manushri-d/ece445/chinmayee/LED_strip_research.png

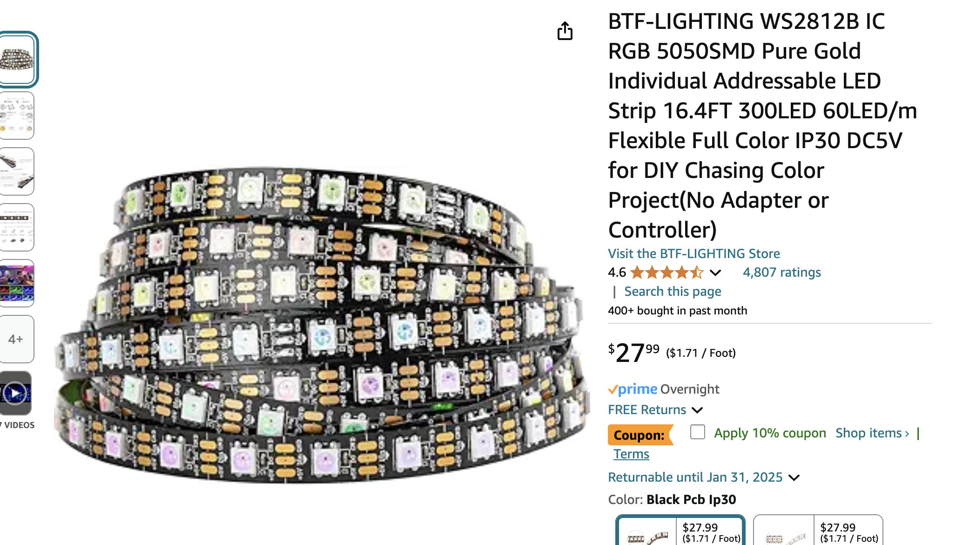
chinmayee/LED_strip_research.png
