manushri-d/ece445/README.md

# Team 41 FA 2024 ECE 445 Digital Lab Notebook

This repo is used for our Senior Design class where we put all of our updates for the semester!

Check [this link](https://courses.grainger.illinois.edu/ece445/projects.asp) for more information on our project (as well as some other projects!)
