manushri-d/ece445/(list of files, cad)

Other CAD files:
platev3.gcode.3mf
boxv3.gcode.3mf
