manushri-d/ece445/mounted_system/PrintedSchematic.pdf

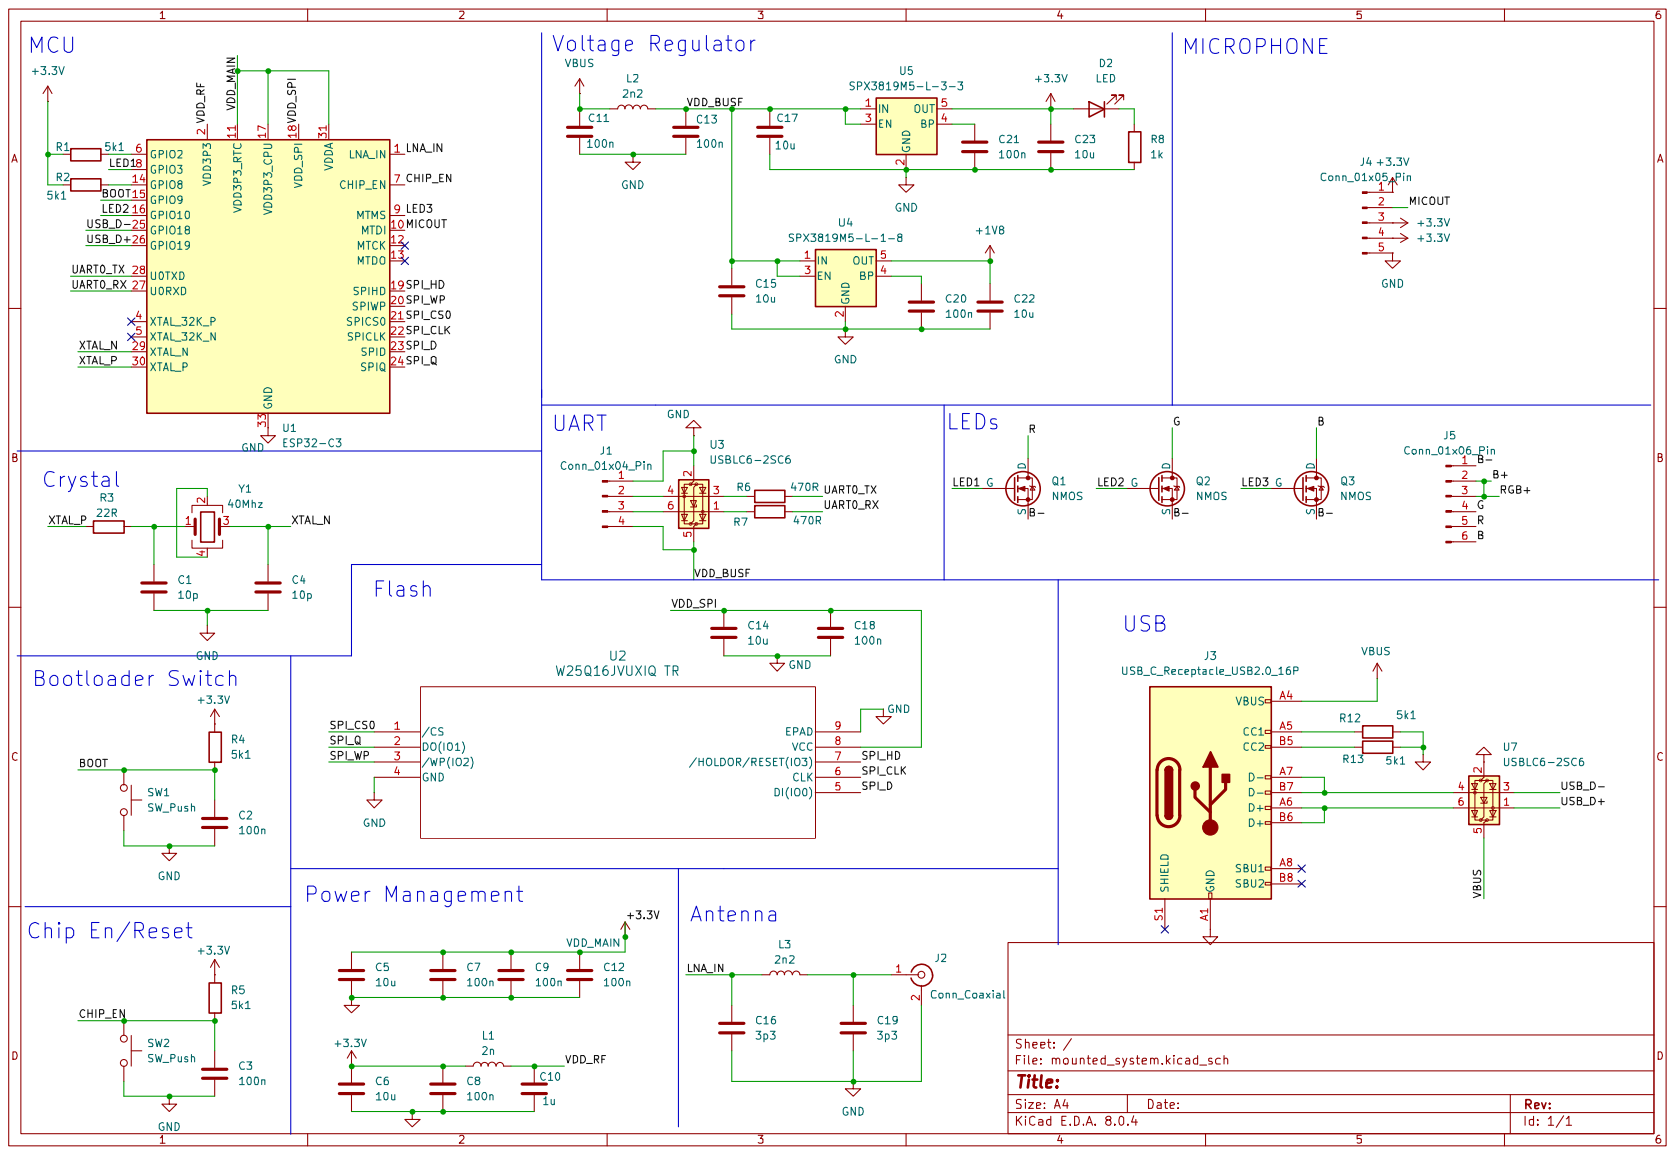
[picture p19: page 1]
