manushri-d/ece445/mounted_system/mounted_system.kicad_pcb

## KiCad design mounted_system/mounted_system.kicad_pcb (2024-11-15)

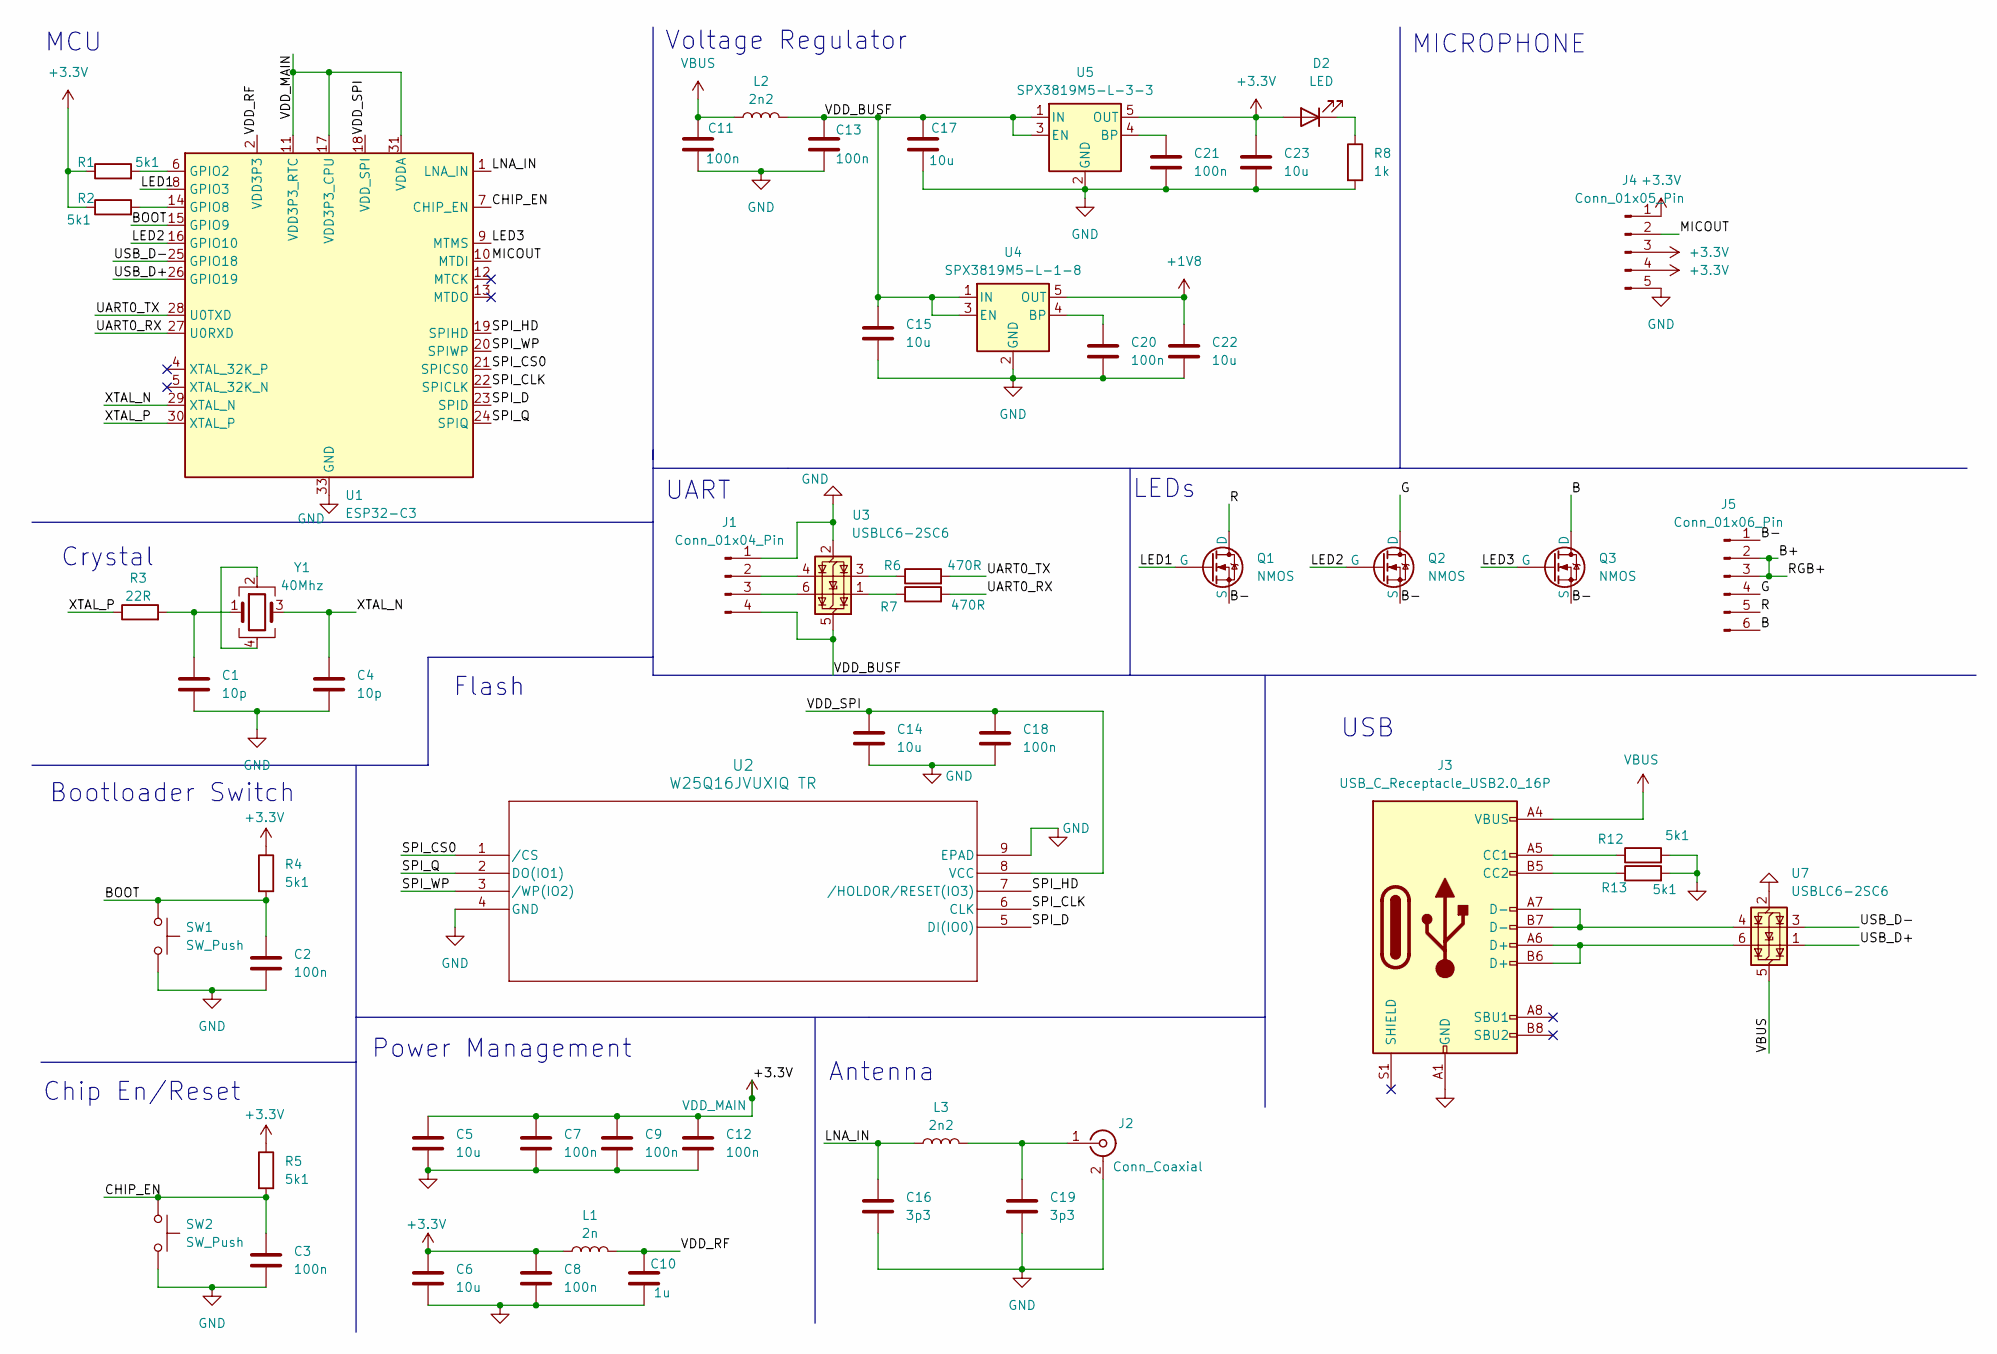
[picture p20: schematic mounted_system.kicad_sch]

Parts:
C1, C4: 10p; C_0805_2012Metric_Pad1.18x1.45mm_HandSolder
C2, C3, C7, C8, C9, C11, C12, C13, C18, C20, C21: 100n; C_0805_2012Metric_Pad1.18x1.45mm_HandSolder
C5, C6, C14, C15, C17, C22, C23: 10u; C_0805_2012Metric_Pad1.18x1.45mm_HandSolder
C10: 1u; C_0805_2012Metric_Pad1.18x1.45mm_HandSolder
C16, C19: 3p3; C_0805_2012Metric_Pad1.18x1.45mm_HandSolder
D2: LED; LED_0805_2012Metric_Pad1.15x1.40mm_HandSolder
J1: Conn_01x04_Pin; PinSocket_1x04_P2.00mm_Vertical
J2: Conn_Coaxial; MMCX_Molex_73415-1471_Vertical
J3: USB_C_Receptacle_USB2.0_16P; USB_C_Receptacle_XKB_U262-16XN-4BVC11
J4: Conn_01x05_Pin; PinSocket_1x05_P2.00mm_Vertical_SMD_Pin1Right
J5: Conn_01x06_Pin; PinSocket_1x06_P2.00mm_Vertical_SMD_Pin1Right
L1: 2n; L_0805_2012Metric_Pad1.15x1.40mm_HandSolder
L2, L3: 2n2; L_0805_2012Metric_Pad1.15x1.40mm_HandSolder
Q1, Q2, Q3: NMOS; TO-247-3_Vertical
R1, R2, R4, R5, R12, R13: 5k1; R_0805_2012Metric_Pad1.20x1.40mm_HandSolder
R3: 22R; R_0805_2012Metric_Pad1.20x1.40mm_HandSolder
R6, R7: 470R; R_0805_2012Metric_Pad1.20x1.40mm_HandSolder
R8: 1k; R_0805_2012Metric_Pad1.20x1.40mm_HandSolder
SW1, SW2: SW_Push; SW_SPST_PTS645
U1: ESP32-C3; QFN-32-1EP_5x5mm_P0.5mm_EP3.7x3.7mm
U2: W25Q16JVUXIQ TR; USON-8_UX_2x3x0p6_WIN
U3, U7: USBLC6-2SC6; SOT-23-6
U4: SPX3819M5-L-1-8; SOT-23-5
U5: SPX3819M5-L-3-3; SOT-23-5
Y1: 40Mhz; Crystal_SMD_EuroQuartz_MQ-4Pin_7.0x5.0mm_HandSoldering

Connections:
+1V8: C22.1, U4.5 (OUT)
+3.3V: C5.1, C6.1, C7.1, C8.1, C9.1, C12.1, C23.1, D2.2 (A), J4.1, J4.3, J4.4, L1.1, R1.1, R2.1, R4.1, R5.1, U1.11 (VDD3P3_RTC), U1.17 (VDD3P3_CPU), U1.31 (VDDA), U1.32 (VDDA), U5.5 (OUT)
/B: J5.6, Q3.1 (D)
/B+: J5.2, J5.3
/B-: J5.1, Q1.3 (S), Q2.3 (S), Q3.3 (S)
/BOOT: C2.1, R4.2, SW1.1, U1.15 (GPIO9)
/CHIP_EN: C3.1, R5.2, SW2.1, U1.7 (CHIP_EN)
/G: J5.4, Q2.1 (D)
/LED1: Q1.2 (G), U1.8 (GPIO3)
/LED2: Q2.2 (G), U1.16 (GPIO10)
/LED3: Q3.2 (G), U1.9 (MTMS)
/LNA_IN: C16.1, L3.1, U1.1 (LNA_IN)
/MICOUT: J4.2, U1.10 (MTDI)
/R: J5.5, Q1.1 (D)
/SPI_CLK: U1.22 (SPICLK), U2.6 (CLK)
/SPI_CS0: U1.21 (SPICS0), U2.1 (/CS)
/SPI_D: U1.23 (SPID), U2.5 (DI(IO0))
/SPI_HD: U1.19 (SPIHD), U2.7 (/HOLDOR/RESET(IO3))
/SPI_Q: U1.24 (SPIQ), U2.2 (DO(IO1))
/SPI_WP: U1.20 (SPIWP), U2.3 (/WP(IO2))
/UART0_RX: R7.2, U1.27 (U0RXD)
/UART0_TX: R6.2, U1.28 (U0TXD)
/USB_D+: U1.26 (GPIO19), U7.1 (I/O1)
/USB_D-: U1.25 (GPIO18), U7.3 (I/O2)
/VDD_BUSF: C13.1, C15.1, C17.1, J1.4, L2.2, U3.5 (VBUS), U4.1 (IN), U4.3 (EN), U5.1 (IN), U5.3 (EN)
/VDD_RF: C10.1, L1.2, U1.2 (VDD3P3), U1.3 (VDD3P3)
/VDD_SPI: C14.1, C18.1, U1.18 (VDD_SPI), U2.8 (VCC)
/XTAL_N: C4.1, U1.29 (XTAL_N), Y1.3
/XTAL_P: R3.1, U1.30 (XTAL_P)
GND: C1.2, C2.2, C3.2, C4.2, C5.2, C6.2, C7.2, C8.2, C9.2, C10.2, C11.2, C12.2, C13.2, C14.2, C15.2, C16.2, C17.2, C18.2, C19.2, C20.2, C21.2, C22.2, C23.2, J1.1, J2.2 (Ext), J3.A1 (GND), J3.A12 (GND), J3.B1 (GND), J3.B12 (GND), J4.5, R8.2, R12.2, R13.2, SW1.2, SW2.2, U1.33 (GND), U2.4 (GND), U2.9 (EPAD), U3.2 (GND), U4.2 (GND), U5.2 (GND), U7.2 (GND)
unnamed: C1.1, R3.2, Y1.1
unnamed: D2.1 (K), R8.1
unnamed: J1.2, U3.4 (I/O2)
unnamed: J1.3, U3.6 (I/O1)
unnamed: C19.1, J2.1 (In), L3.2
unnamed: J3.A5 (CC1), R12.1
unnamed: J3.B5 (CC2), R13.1
unnamed: J3.A6 (D+), J3.B6 (D+), U7.6 (I/O1)
unnamed: J3.A7 (D-), J3.B7 (D-), U7.4 (I/O2)
unnamed: R6.1, U3.3 (I/O2)
unnamed: R7.1, U3.1 (I/O1)
unnamed: R1.2, U1.6 (GPIO2)
unnamed: R2.2, U1.14 (GPIO8)
unnamed: C20.1, U4.4 (BP)
unnamed: C21.1, U5.4 (BP)
unnamed: Y1.2, Y1.4
VBUS: C11.1, J3.A4 (VBUS), J3.A9 (VBUS), J3.B4 (VBUS), J3.B9 (VBUS), L2.1, U7.5 (VBUS)

Notes on the sheet:
USB
UART
MCU
Chip En/Reset
Voltage Regulator
Bootloader Switch
MICROPHONE
Crystal
Antenna
Power Management
LEDs
Flash

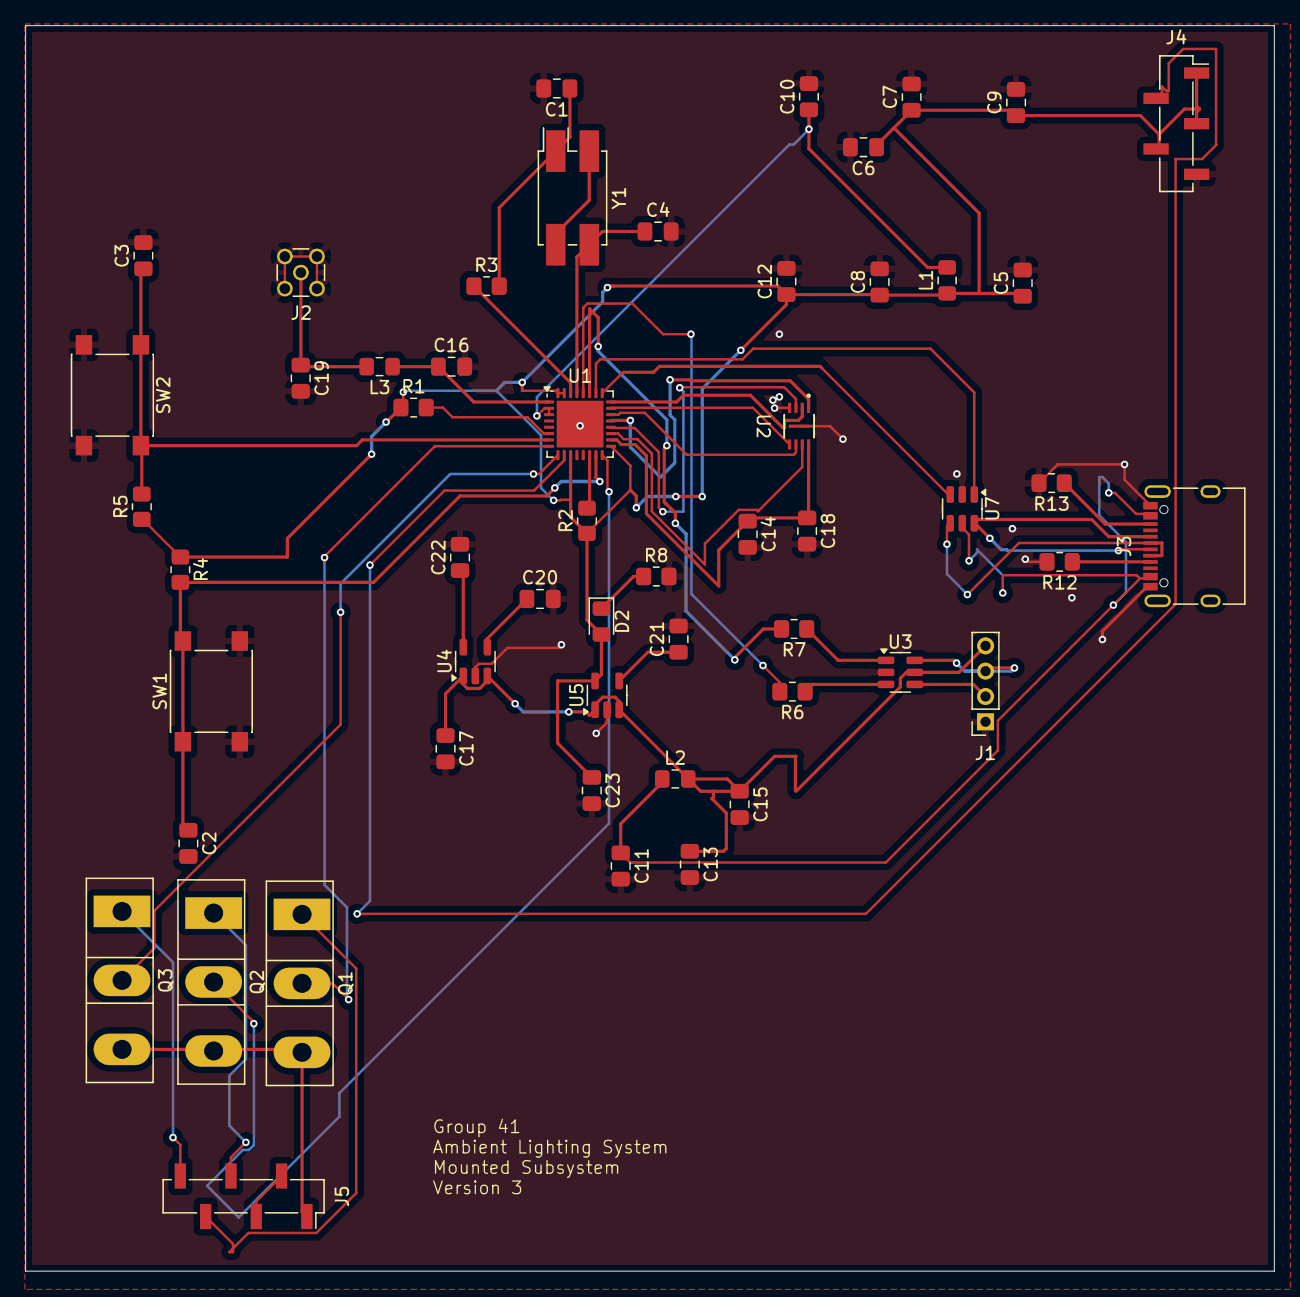
[picture p21: board mounted_system.kicad_pcb from above]

Board: 2 copper layers, 98.7 x 98.4 mm, 54 parts (0 on the bottom side), 47 nets.
