manushri-d/ece445/wearablesystem/wearablesystem.kicad_pcb

## KiCad design wearablesystem/wearablesystem.kicad_pcb (2024-11-14)

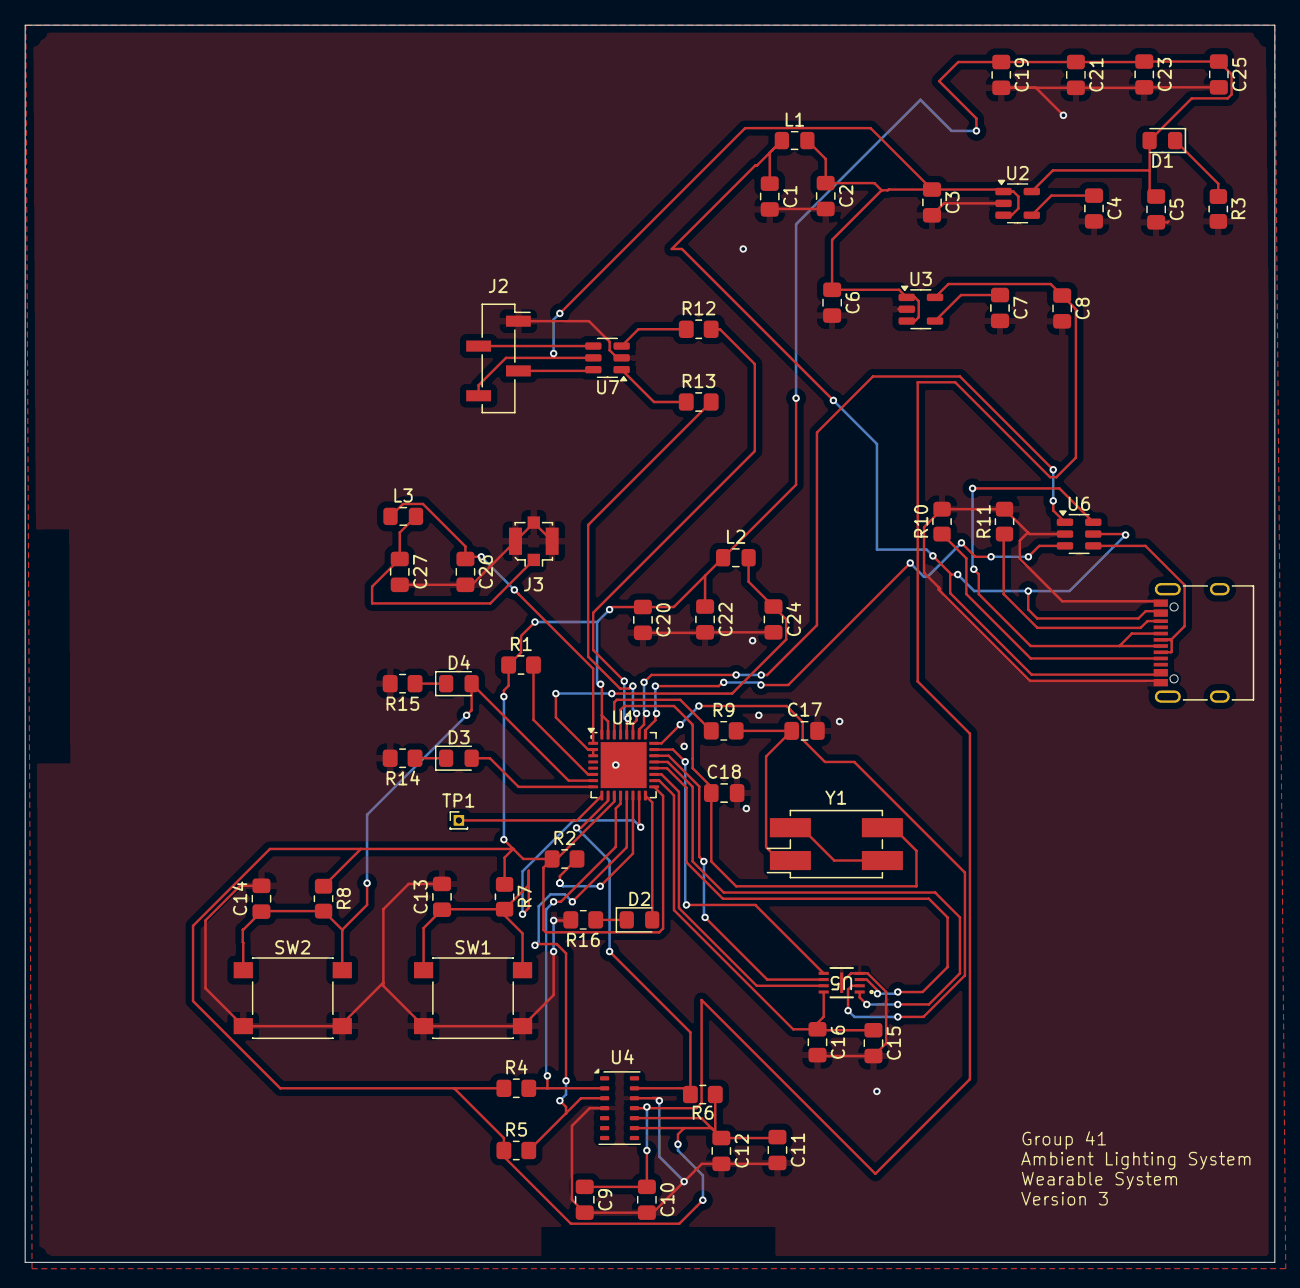
[picture p22: board wearablesystem.kicad_pcb from above]

Board: 2 copper layers, 100.5 x 99.5 mm, 64 parts (0 on the bottom side), 47 nets.

Parts:
C1, C2, C4, C7, C9, C12, C13, C14, C16, C21, C22, C23, C25: 100n; C_0805_2012Metric_Pad1.18x1.45mm_HandSolder
C3, C5, C6, C8, C10, C15, C19, C20: 10u; C_0805_2012Metric_Pad1.18x1.45mm_HandSolder
C11, C24: 1u; C_0805_2012Metric_Pad1.18x1.45mm_HandSolder
C17, C18: 10p; C_0805_2012Metric_Pad1.18x1.45mm_HandSolder
C26, C27: 3p3; C_0805_2012Metric_Pad1.18x1.45mm_HandSolder
D1, D2, D3, D4: LED; LED_0805_2012Metric_Pad1.15x1.40mm_HandSolder
J1: USB_C_Receptacle_USB2.0_16P; USB_C_Receptacle_XKB_U262-16XN-4BVC11
J2: Conn_01x04_Pin; PinSocket_1x04_P2.00mm_Vertical_SMD_Pin1Right
J3: Conn_Coaxial; U.FL_Molex_MCRF_73412-0110_Vertical
L1, L3: 2n2; L_0805_2012Metric_Pad1.15x1.40mm_HandSolder
L2: 2n; L_0805_2012Metric_Pad1.15x1.40mm_HandSolder
R1, R2, R7, R8, R10, R11: 5k1; R_0805_2012Metric_Pad1.20x1.40mm_HandSolder
R3, R14, R15, R16: 1k; R_0805_2012Metric_Pad1.20x1.40mm_HandSolder
R4, R5, R6: 1k5; R_0805_2012Metric_Pad1.20x1.40mm_HandSolder
R9: 22R; R_0805_2012Metric_Pad1.20x1.40mm_HandSolder
R12, R13: 470R; R_0805_2012Metric_Pad1.20x1.40mm_HandSolder
SW1, SW2: SW_Push; SW_SPST_PTS645
TP1: TestPoint; PinHeader_1x01_P1.00mm_Vertical
U1: ESP32-C3; QFN-32-1EP_5x5mm_P0.5mm_EP3.7x3.7mm
U2: SPX3819M5-L-3-3; SOT-23-5
U3: SPX3819M5-L-1-8; SOT-23-5
U4: MAX30102; Maxim_OLGA-14_3.3x5.6mm_P0.8mm
U5: W25Q16JVUXIQ TR; USON-8_UX_2x3x0p6_WIN
U6, U7: USBLC6-2SC6; SOT-23-6
Y1: 40Mhz; Crystal_SMD_EuroQuartz_MQ-4Pin_7.0x5.0mm_HandSoldering

Connections:
+1V8: C8.1, C9.1, C10.1, U3.5 (OUT), U4.11 (VDD)
+3.3V: C5.1, C11.1, C12.1, C19.1, C20.1, C21.1, C22.1, C23.1, C25.1, D1.2 (A), L2.1, R1.1, R2.1, R4.1, R5.1, R6.1, R7.1, R8.1, U1.11 (VDD3P3_RTC), U1.17 (VDD3P3_CPU), U1.31 (VDDA), U1.32 (VDDA), U2.5 (OUT), U4.9 (VLED+), U4.10 (VLED+)
/BOOT: C13.1, R7.2, SW1.1, U1.15 (GPIO9)
/CHIP_EN: C14.1, D4.2 (A), R8.2, SW2.1, U1.7 (CHIP_EN)
/INT: R6.2, U1.10 (MTDI), U4.13 (~INT)
/LED1: D3.2 (A), U1.8 (GPIO3)
/LED2: D2.2 (A), U1.16 (GPIO10)
/LNA_IN: C26.1, L3.1, U1.1 (LNA_IN)
/MTMS: TP1.1, U1.9 (MTMS)
/SCL: R4.2, U1.12 (MTCK), U4.2 (SCL)
/SDA: R5.2, U1.13 (MTDO), U4.3 (SDA)
/SPI_CLK: U1.22 (SPICLK), U5.6 (CLK)
/SPI_CS0: U1.21 (SPICS0), U5.1 (/CS)
/SPI_D: U1.23 (SPID), U5.5 (DI(IO0))
/SPI_HD: U1.19 (SPIHD), U5.7 (/HOLDOR/RESET(IO3))
/SPI_Q: U1.24 (SPIQ), U5.2 (DO(IO1))
/SPI_WP: U1.20 (SPIWP), U5.3 (/WP(IO2))
/UART0_RX: R13.2, U1.27 (U0RXD)
/UART0_TX: R12.2, U1.28 (U0TXD)
/USB_D+: U1.26 (GPIO19), U6.1 (I/O1)
/USB_D-: U1.25 (GPIO18), U6.3 (I/O2)
/VDD_BUSF: C2.1, C3.1, C6.1, J2.4, L1.2, U2.1 (IN), U2.3 (EN), U3.1 (IN), U3.3 (EN), U7.5 (VBUS)
/VDD_RF: C24.1, L2.2, U1.2 (VDD3P3), U1.3 (VDD3P3)
/VDD_SPI: C15.1, C16.1, U1.18 (VDD_SPI), U5.8 (VCC)
/XTAL_N: C18.1, U1.29 (XTAL_N), Y1.3
/XTAL_P: R9.1, U1.30 (XTAL_P)
GND: C1.2, C2.2, C3.2, C4.2, C5.2, C6.2, C7.2, C8.2, C9.2, C10.2, C11.2, C12.2, C13.2, C14.2, C15.2, C16.2, C17.2, C18.2, C19.2, C20.2, C21.2, C22.2, C23.2, C24.2, C25.2, C26.2, C27.2, J1.A1 (GND), J1.A12 (GND), J1.B1 (GND), J1.B12 (GND), J2.1, J3.2 (Ext), R3.2, R10.2, R11.2, R14.2, R15.2, R16.2, SW1.2, SW2.2, U1.33 (GND), U2.2 (GND), U3.2 (GND), U4.4 (PGND), U4.12 (GND), U5.4 (GND), U5.9 (EPAD), U6.2 (GND), U7.2 (GND)
unnamed: C17.1, R9.2, Y1.1
unnamed: D1.1 (K), R3.1
unnamed: D2.1 (K), R16.1
unnamed: D3.1 (K), R14.1
unnamed: D4.1 (K), R15.1
unnamed: J1.A5 (CC1), R10.1
unnamed: J1.B5 (CC2), R11.1
unnamed: J1.A6 (D+), J1.B6 (D+), U6.6 (I/O1)
unnamed: J1.A7 (D-), J1.B7 (D-), U6.4 (I/O2)
unnamed: J2.2, U7.4 (I/O2)
unnamed: J2.3, U7.6 (I/O1)
unnamed: C27.1, J3.1 (In), L3.2
unnamed: R12.1, U7.3 (I/O2)
unnamed: R13.1, U7.1 (I/O1)
unnamed: R1.2, U1.6 (GPIO2)
unnamed: R2.2, U1.14 (GPIO8)
unnamed: C4.1, U2.4 (BP)
unnamed: C7.1, U3.4 (BP)
unnamed: Y1.2, Y1.4
VBUS: C1.1, J1.A4 (VBUS), J1.A9 (VBUS), J1.B4 (VBUS), J1.B9 (VBUS), L1.1, U6.5 (VBUS)
