manushri-d/ece445/(commit log)

2024-11-06 Adding Mounted Subsystem
    [mounted_system-B_Cu.gbr, mounted_system-B_Mask.gbr, mounted_system-B_Paste.gbr, mounted_system-B_Silkscreen.gbr, mounted_system-Edge_Cuts.gbr, mounted_system-F_Cu.gbr, mounted_system-F_Mask.gbr, mounted_system-F_Paste.gbr]
2024-11-06 adding wearable system
    [wearablesystem-B_Cu.gbr, wearablesystem-B_Mask.gbr, wearablesystem-B_Paste.gbr, wearablesystem-B_Silkscreen.gbr, wearablesystem-Edge_Cuts.gbr, wearablesystem-F_Cu.gbr, wearablesystem-F_Mask.gbr, wearablesystem-F_Paste.gbr]
2024-11-12 maybe fixed errors
    [mounted_system.kicad_pcb]
2024-11-12 added files plus gerber
    [mounted_system-B_Cu.gbr, mounted_system-B_Mask.gbr, mounted_system-B_Paste.gbr, mounted_system-B_Silkscreen.gbr, mounted_system-Edge_Cuts.gbr, mounted_system-F_Cu.gbr, mounted_system-F_Mask.gbr, mounted_system-F_Paste.gbr]
2024-11-14 adding new files
    [wearablesystem-B_Cu.gbr, wearablesystem-B_Mask.gbr, wearablesystem-B_Paste.gbr, wearablesystem-B_Silkscreen.gbr, wearablesystem-Edge_Cuts.gbr, wearablesystem-F_Cu.gbr, wearablesystem-F_Mask.gbr, wearablesystem-F_Paste.gbr]
2024-11-15 fully updated pcb
    [mounted_system-B_Cu.gbr, mounted_system-B_Mask.gbr, mounted_system-B_Paste.gbr, mounted_system-Edge_Cuts.gbr, mounted_system-F_Cu.gbr, mounted_system-F_Mask.gbr, mounted_system-F_Paste.gbr, mounted_system-F_Silkscreen.gbr]
2024-12-11 adding bambu files
    [boxv3.gcode.3mf, platev3.gcode.3mf]
